Fanza97/DRAM-Tester/High Level Scheme.pdf

## SCRITTURA IN MEMORIA

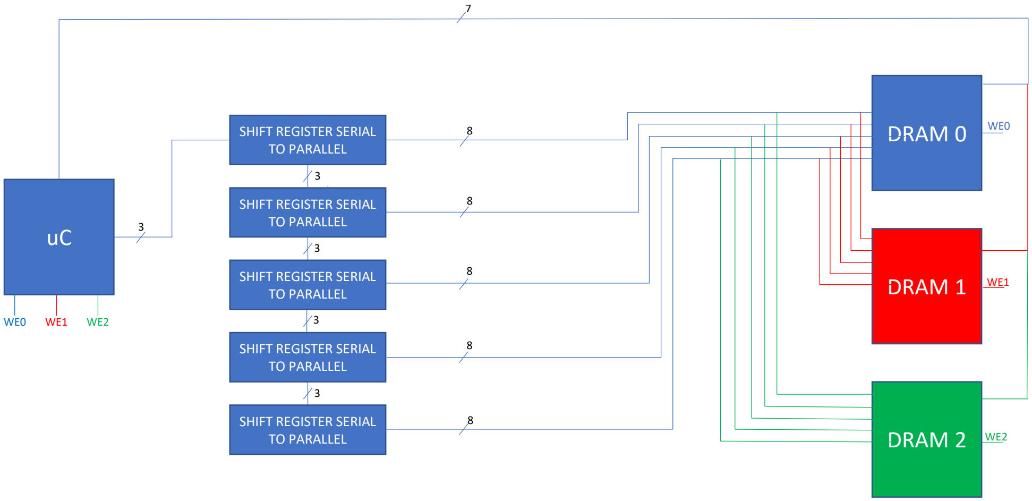
[picture p1: figure]
SHIFT REGISTER SERIAL TO PARALLEL; DRAM 0; DRAM 1; DRAM 2

## LETTURA DA MEMORIA

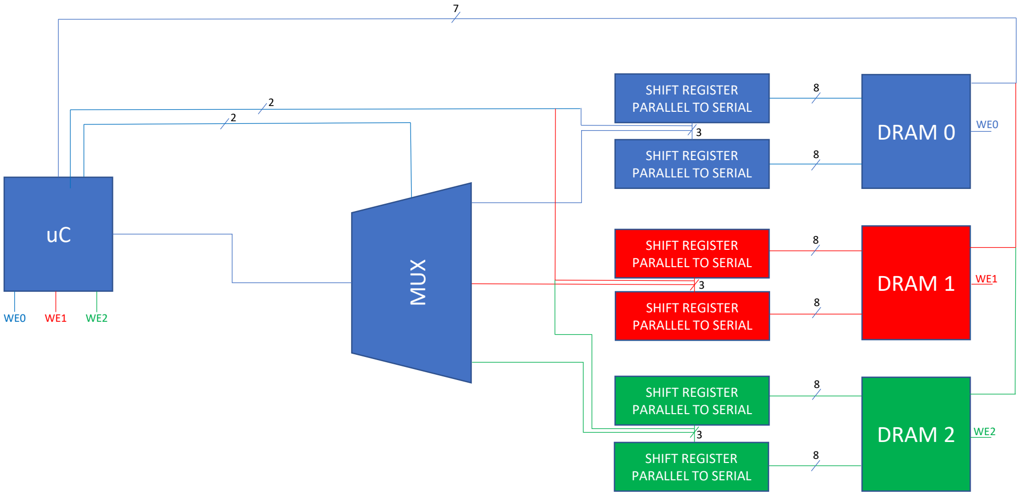
[picture p2: figure]
SHIFT REGISTER PARALLEL TO SERIAL; DRAM 0; DRAM 1; DRAM 2; MUX
