Fanza97/DRAM-Tester/Signals_Timing.pdf

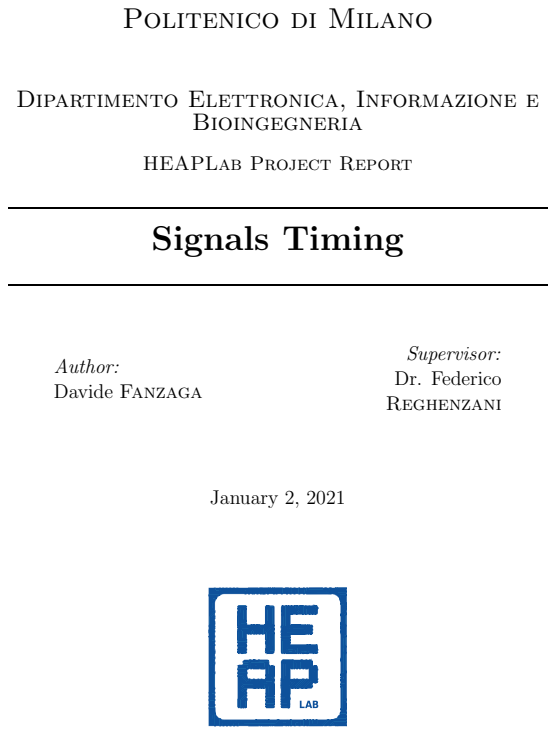
[picture p3: page 1]
Bioingegneria; Signals Timing; Author: Davide Fanzaga; Supervisor: Dr. Federico; Reghenzani; January 2, 2021

Politenico di Milano

Dipartimento Elettronica, Informazione e

HEAPLab Project Report

### 1 READ

### 1.1 DRAM

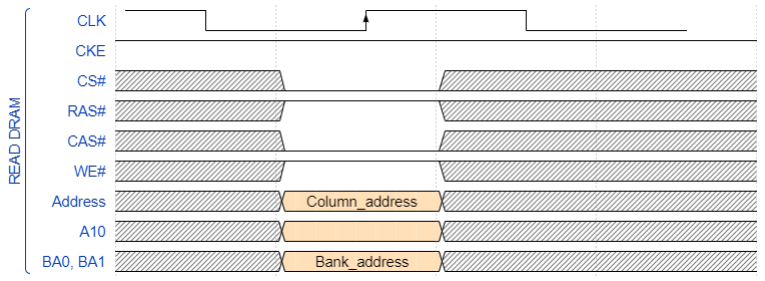
[picture p4: figure]

### 1.2 Shift Register Parallel to Serial

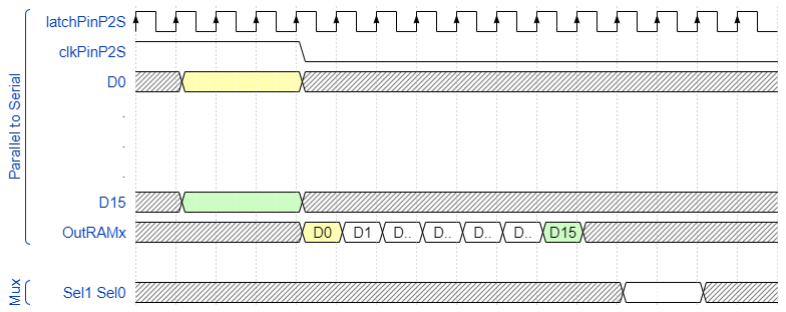
[picture p5: figure]

1

### 2 WRITE

### 2.1 DRAM

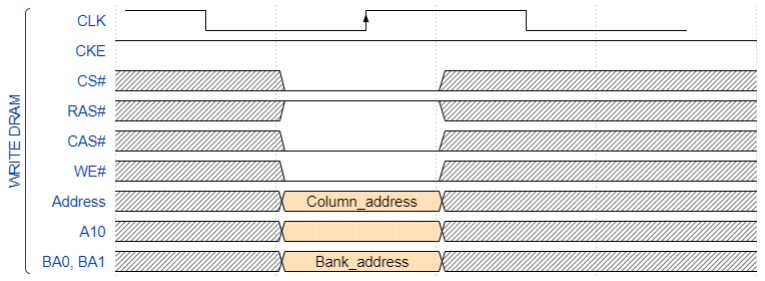
[picture p6: figure]

### 2.2 Shift RegisterSerial to Parallel

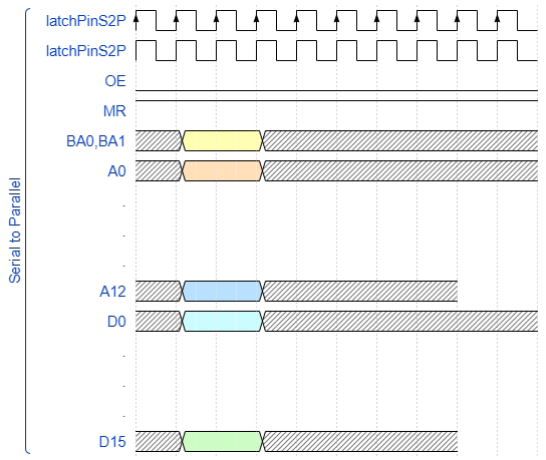
[picture p7: figure]

2
