Fanza97/DRAM-Tester/PCB_Design/PCB_Design.kicad_pcb

## KiCad design PCB_Design/PCB_Design.kicad_pcb (2021-08-06)

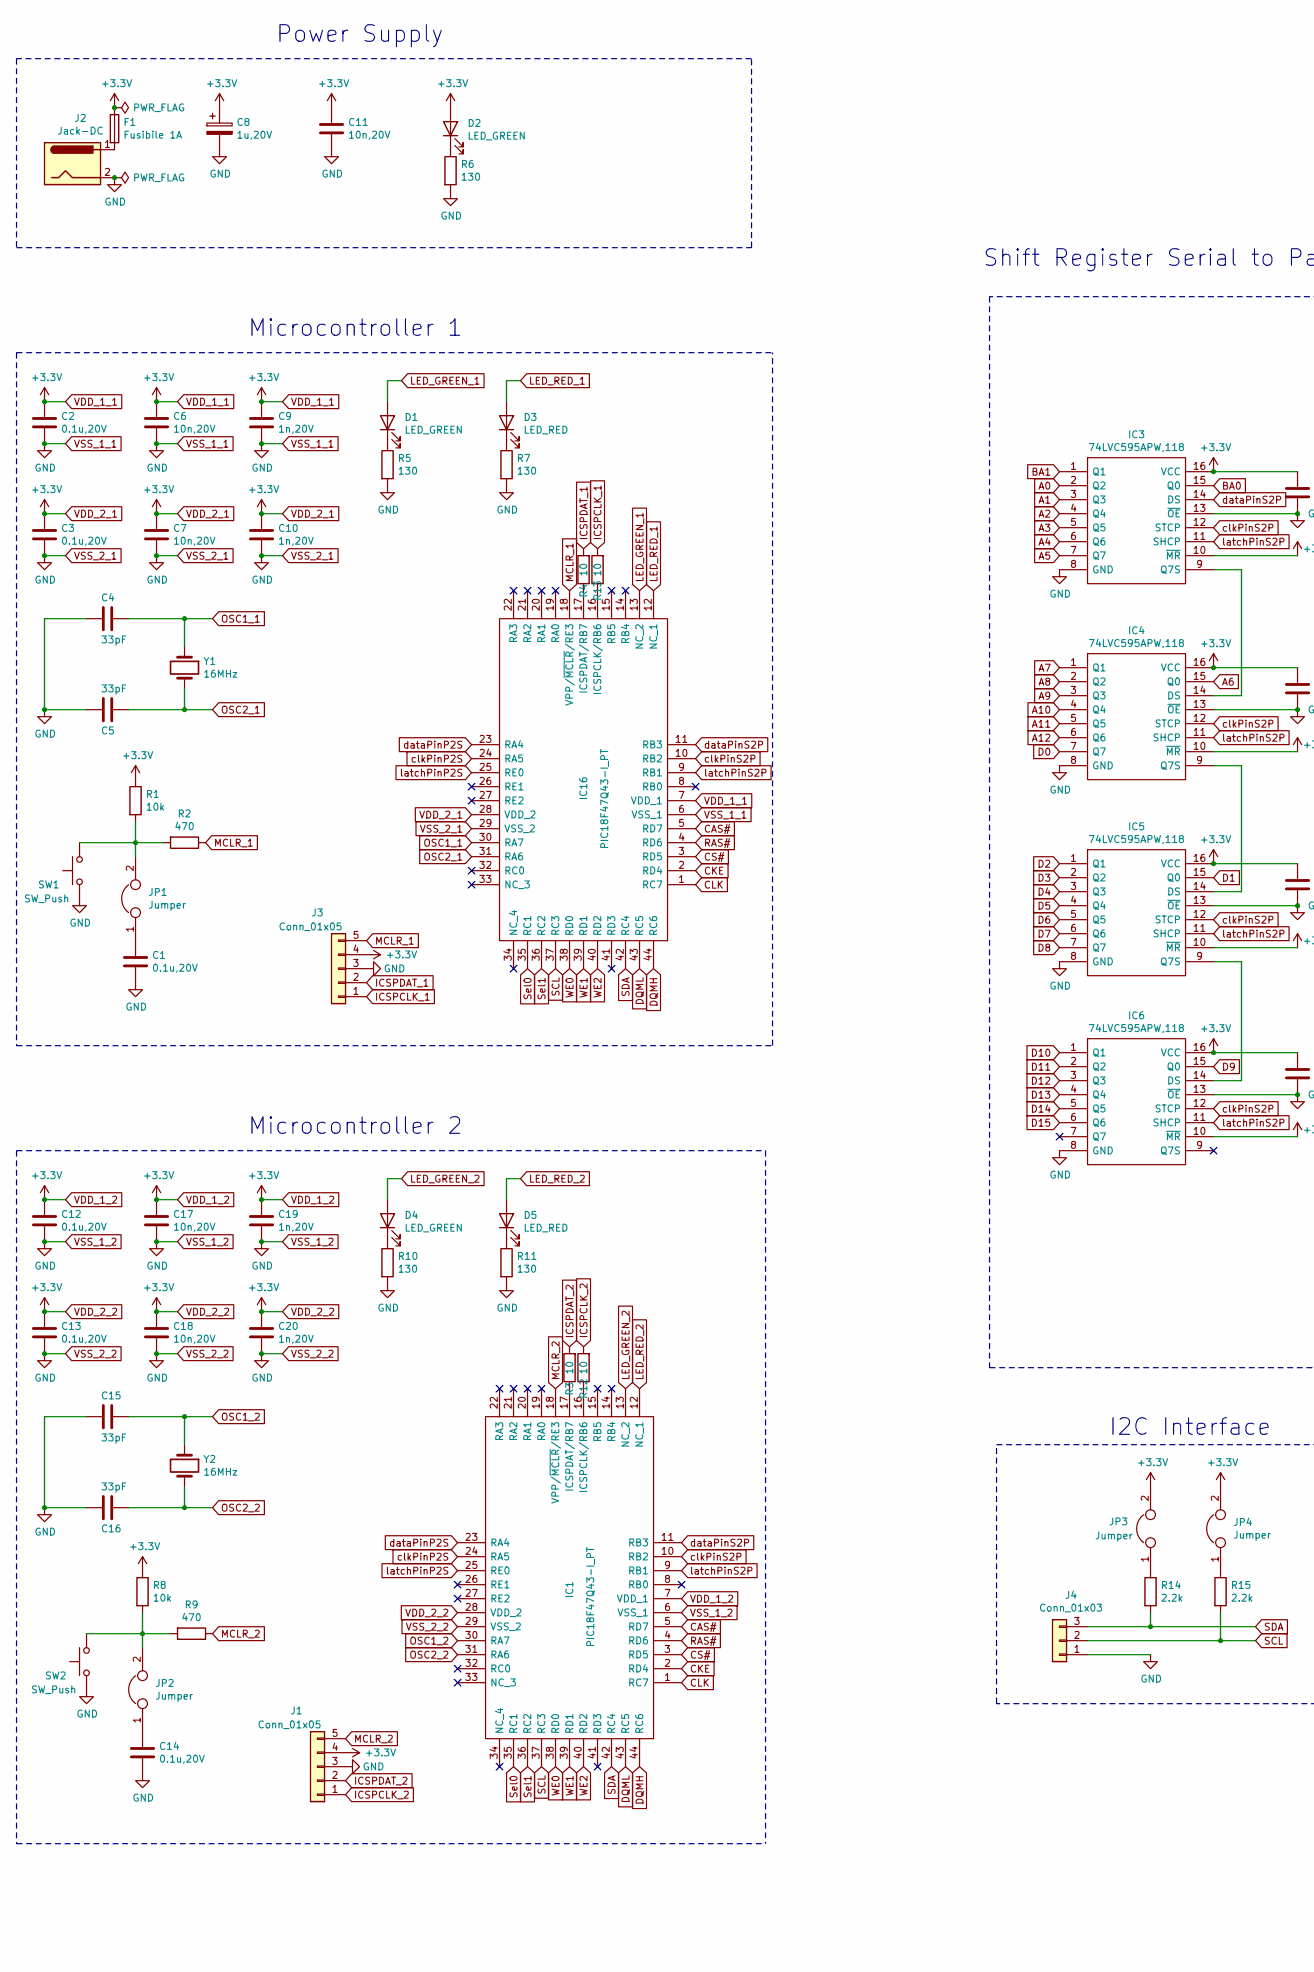
[picture p8: schematic PCB_Design.sch, part in row 1, column 1]

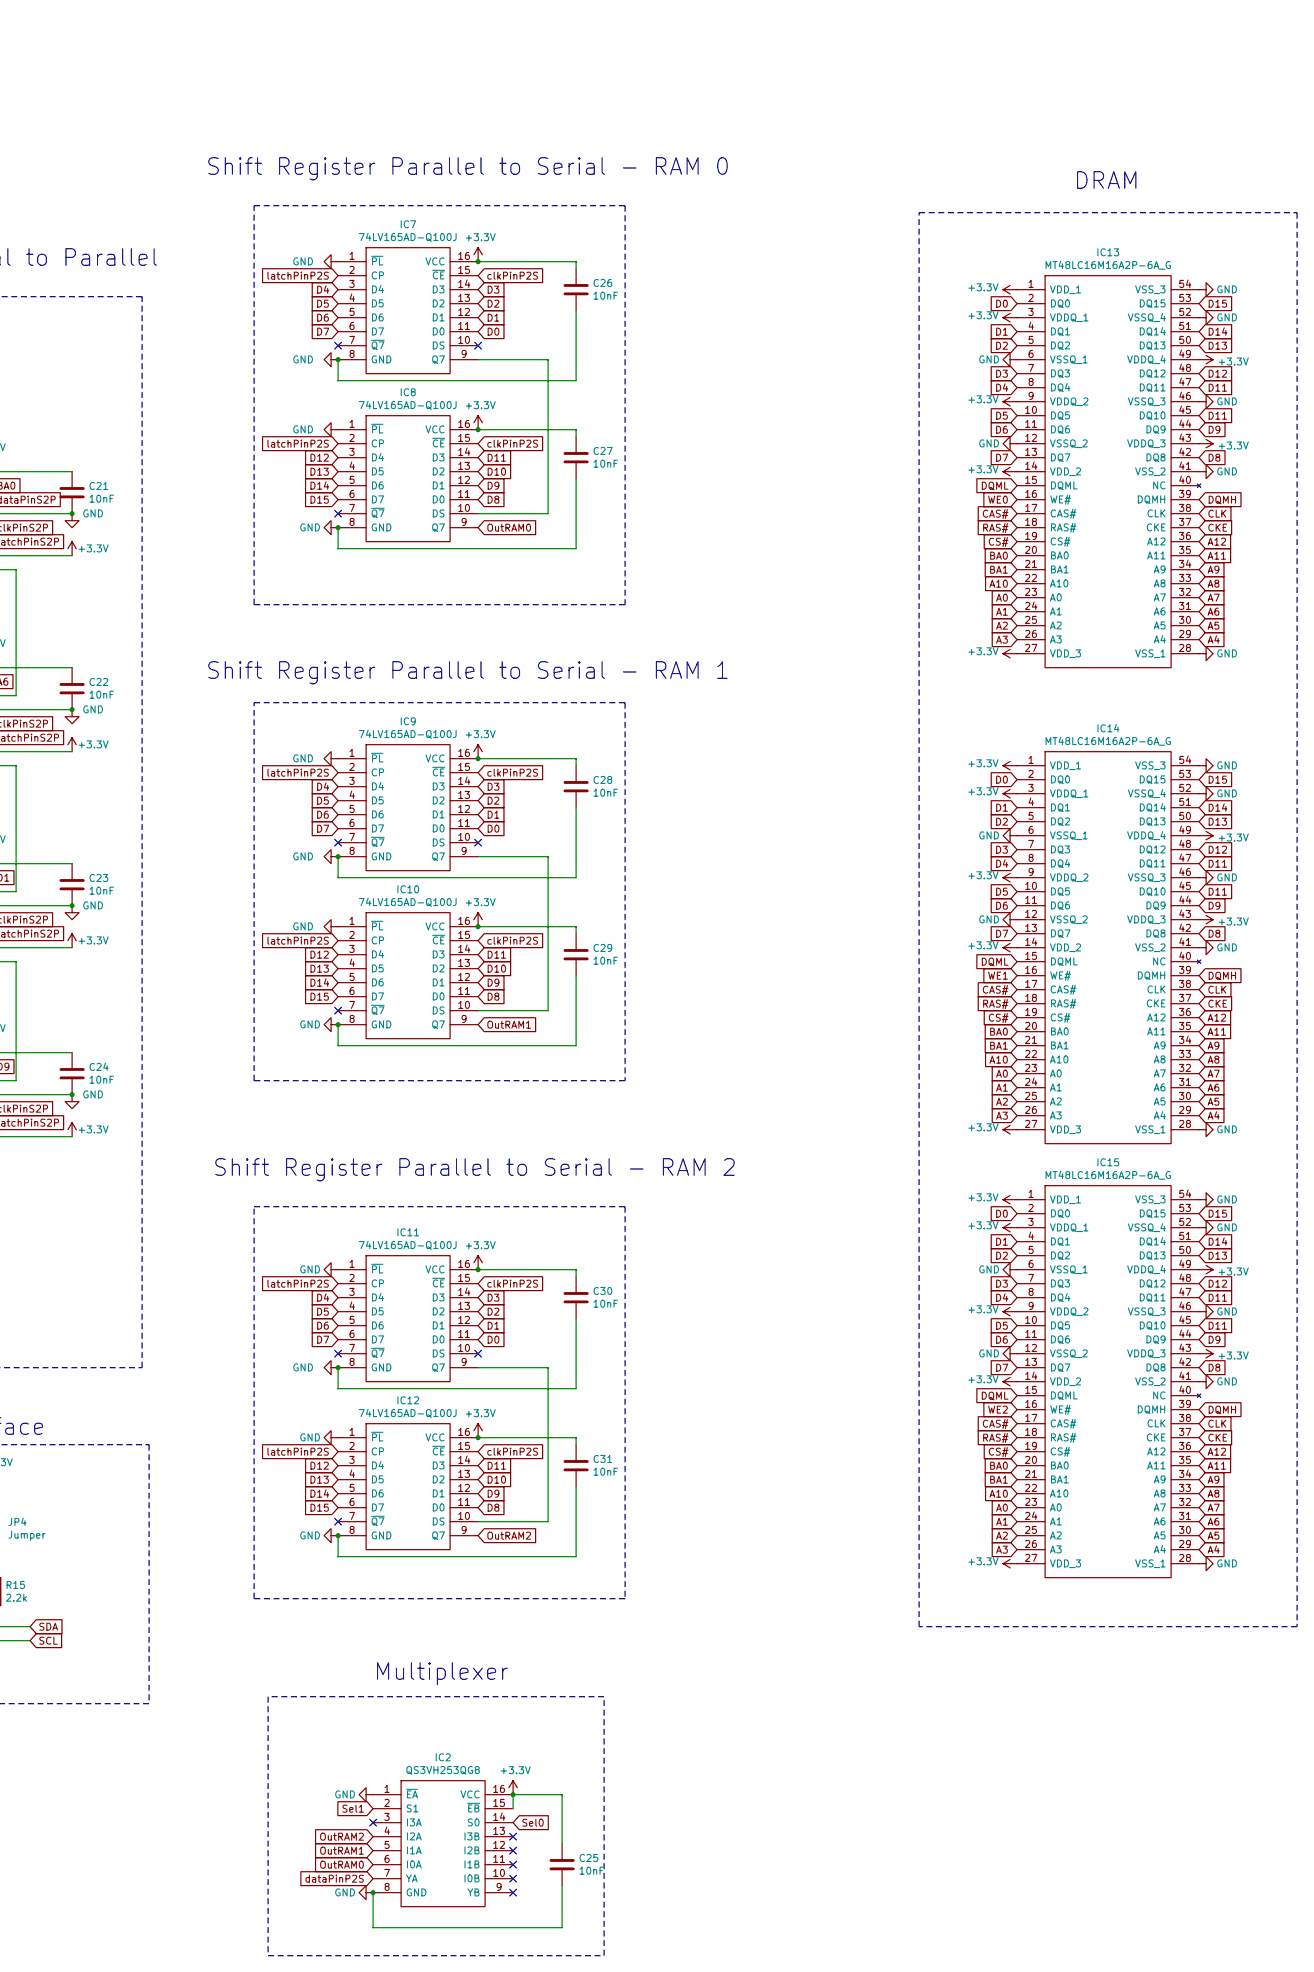
[picture p9: schematic PCB_Design.sch, part in row 1, column 2]

Parts:
C1, C2, C3, C12, C13, C14: 0.1u,20V; C_0805_2012Metric_Pad1.15x1.40mm_HandSolder
C4, C5, C15, C16: 33pF; C_0805_2012Metric_Pad1.15x1.40mm_HandSolder
C6, C7, C11, C17, C18: 10n,20V; C_0805_2012Metric_Pad1.15x1.40mm_HandSolder
C8: 1u,20V; CP_Elec_4x4.5
C9, C10, C19, C20: 1n,20V; C_0805_2012Metric_Pad1.15x1.40mm_HandSolder
C21, C22, C23, C24, C25, C26, C27, C28, C29, C30, C31: 10nF; C_0805_2012Metric_Pad1.15x1.40mm_HandSolder
D1, D2, D4: LED_GREEN; LED_0805_2012Metric_Pad1.15x1.40mm_HandSolder
D3, D5: LED_RED; LED_0805_2012Metric_Pad1.15x1.40mm_HandSolder
F1: Fusibile 1A; Fuseholder_Cylinder-5x20mm_Schurter_0031_8201_Horizontal_Op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
IC1, IC16: PIC18F47Q43-I_PT; QFP80P1200X1200X120-44N; Mouser Part Number 579-PIC18F47Q43-I/PT
IC2: QS3VH253QG8; SOP64P602X173-16N; Mouser Part Number 972-QS3VH253QG8
IC3, IC4, IC5, IC6: 74LVC595APW,118; SOP65P640X110-16N; Mouser Part Number 771-LVC595APW118
IC7, IC8, IC9, IC10, IC11, IC12: 74LV165AD-Q100J; SOIC127P600X175-16N; Mouser Part Number 771-74LV165ADQ100J
IC13, IC14, IC15: MT48LC16M16A2P-6A_G; SOP80P1176X120-54N; Mouser Part Number 340-128308-TRAY
J1, J3: Conn_01x05; PinHeader_1x05_P2.54mm_Vertical
J2: Jack-DC; BarrelJack_CUI_PJ-063AH_Horizontal
J4: Conn_01x03; PinHeader_1x03_P2.54mm_Vertical
JP1, JP2, JP3, JP4: Jumper; TestPoint_Bridge_Pitch2.54mm_Drill1.0mm
R1, R8: 10k; R_0805_2012Metric_Pad1.15x1.40mm_HandSolder
R2, R9: 470; R_0805_2012Metric_Pad1.15x1.40mm_HandSolder
R3, R4, R12, R13: 10; R_0805_2012Metric_Pad1.15x1.40mm_HandSolder
R5, R6, R7, R10, R11: 130; R_0805_2012Metric_Pad1.15x1.40mm_HandSolder
R14, R15: 2.2k; R_0805_2012Metric_Pad1.15x1.40mm_HandSolder
SW1, SW2: SW_Push; SW_PUSH_6mm_H5mm
Y1, Y2: 16MHz; Crystal_SMD_HC49-SD

Connections:
A0: IC3.2 (Q2), IC13.23 (A0), IC14.23 (A0), IC15.23 (A0)
A1: IC3.3 (Q3), IC13.24 (A1), IC14.24 (A1), IC15.24 (A1)
A2: IC3.4 (Q4), IC13.25 (A2), IC14.25 (A2), IC15.25 (A2)
A3: IC3.5 (Q5), IC13.26 (A3), IC14.26 (A3), IC15.26 (A3)
A4: IC3.6 (Q6), IC13.29 (A4), IC14.29 (A4), IC15.29 (A4)
A5: IC3.7 (Q7), IC13.30 (A5), IC14.30 (A5), IC15.30 (A5)
A6: IC4.15 (Q0), IC13.31 (A6), IC14.31 (A6), IC15.31 (A6)
A7: IC4.1 (Q1), IC13.32 (A7), IC14.32 (A7), IC15.32 (A7)
A8: IC4.2 (Q2), IC13.33 (A8), IC14.33 (A8), IC15.33 (A8)
A9: IC4.3 (Q3), IC13.34 (A9), IC14.34 (A9), IC15.34 (A9)
A10: IC4.4 (Q4), IC13.22 (A10), IC14.22 (A10), IC15.22 (A10)
A11: IC4.5 (Q5), IC13.35 (A11), IC14.35 (A11), IC15.35 (A11)
A12: IC4.6 (Q6), IC13.36 (A12), IC14.36 (A12), IC15.36 (A12)
BA0: IC3.15 (Q0), IC13.20 (BA0), IC14.20 (BA0), IC15.20 (BA0)
BA1: IC3.1 (Q1), IC13.21 (BA1), IC14.21 (BA1), IC15.21 (BA1)
CAS#: IC1.5 (RD7), IC13.17 (CAS#), IC14.17 (CAS#), IC15.17 (CAS#), IC16.5 (RD7)
CKE: IC1.2 (RD4), IC13.37 (CKE), IC14.37 (CKE), IC15.37 (CKE), IC16.2 (RD4)
CLK: IC1.1 (RC7), IC13.38 (CLK), IC14.38 (CLK), IC15.38 (CLK), IC16.1 (RC7)
CS#: IC1.3 (RD5), IC13.19 (CS#), IC14.19 (CS#), IC15.19 (CS#), IC16.3 (RD5)
D0: IC4.7 (Q7), IC7.11 (D0), IC9.11 (D0), IC11.11 (D0), IC13.2 (DQ0), IC14.2 (DQ0), IC15.2 (DQ0)
D1: IC5.15 (Q0), IC7.12 (D1), IC9.12 (D1), IC11.12 (D1), IC13.4 (DQ1), IC14.4 (DQ1), IC15.4 (DQ1)
D2: IC5.1 (Q1), IC7.13 (D2), IC9.13 (D2), IC11.13 (D2), IC13.5 (DQ2), IC14.5 (DQ2), IC15.5 (DQ2)
D3: IC5.2 (Q2), IC7.14 (D3), IC9.14 (D3), IC11.14 (D3), IC13.7 (DQ3), IC14.7 (DQ3), IC15.7 (DQ3)
D4: IC5.3 (Q3), IC7.3 (D4), IC9.3 (D4), IC11.3 (D4), IC13.8 (DQ4), IC14.8 (DQ4), IC15.8 (DQ4)
D5: IC5.4 (Q4), IC7.4 (D5), IC9.4 (D5), IC11.4 (D5), IC13.10 (DQ5), IC14.10 (DQ5), IC15.10 (DQ5)
D6: IC5.5 (Q5), IC7.5 (D6), IC9.5 (D6), IC11.5 (D6), IC13.11 (DQ6), IC14.11 (DQ6), IC15.11 (DQ6)
D7: IC5.6 (Q6), IC7.6 (D7), IC9.6 (D7), IC11.6 (D7), IC13.13 (DQ7), IC14.13 (DQ7), IC15.13 (DQ7)
D8: IC5.7 (Q7), IC8.11 (D0), IC10.11 (D0), IC12.11 (D0), IC13.42 (DQ8), IC14.42 (DQ8), IC15.42 (DQ8)
D9: IC6.15 (Q0), IC8.12 (D1), IC10.12 (D1), IC12.12 (D1), IC13.44 (DQ9), IC14.44 (DQ9), IC15.44 (DQ9)
D10: IC6.1 (Q1), IC8.13 (D2), IC10.13 (D2), IC12.13 (D2)
D11: IC6.2 (Q2), IC8.14 (D3), IC10.14 (D3), IC12.14 (D3), IC13.45 (DQ10), IC13.47 (DQ11), IC14.45 (DQ10), IC14.47 (DQ11), IC15.45 (DQ10), IC15.47 (DQ11)
D12: IC6.3 (Q3), IC8.3 (D4), IC10.3 (D4), IC12.3 (D4), IC13.48 (DQ12), IC14.48 (DQ12), IC15.48 (DQ12)
D13: IC6.4 (Q4), IC8.4 (D5), IC10.4 (D5), IC12.4 (D5), IC13.50 (DQ13), IC14.50 (DQ13), IC15.50 (DQ13)
D14: IC6.5 (Q5), IC8.5 (D6), IC10.5 (D6), IC12.5 (D6), IC13.51 (DQ14), IC14.51 (DQ14), IC15.51 (DQ14)
D15: IC6.6 (Q6), IC8.6 (D7), IC10.6 (D7), IC12.6 (D7), IC13.53 (DQ15), IC14.53 (DQ15), IC15.53 (DQ15)
DQMH: IC1.44 (RC6), IC13.39 (DQMH), IC14.39 (DQMH), IC15.39 (DQMH), IC16.44 (RC6)
DQML: IC1.43 (RC5), IC13.15 (DQML), IC14.15 (DQML), IC15.15 (DQML), IC16.43 (RC5)
ICSPCLK_1: J3.1, R13.2
ICSPCLK_2: J1.1, R12.2
ICSPDAT_1: J3.2, R4.2
ICSPDAT_2: J1.2, R3.2
LED_GREEN_1: D1.2 (A), IC16.13 (NC_2)
LED_GREEN_2: D4.2 (A), IC1.13 (NC_2)
LED_RED_1: D3.2 (A), IC16.12 (NC_1)
LED_RED_2: D5.2 (A), IC1.12 (NC_1)
MCLR_1: IC16.18 (VPP/~MCLR~/RE3), J3.5, R2.1
MCLR_2: IC1.18 (VPP/~MCLR~/RE3), J1.5, R9.1
unnamed: C1.2, JP1.1
unnamed: C14.2, JP2.1
unnamed: D1.1 (K), R5.1
unnamed: D2.1 (K), R6.1
unnamed: D3.1 (K), R7.1
unnamed: D4.1 (K), R10.1
unnamed: D5.1 (K), R11.1
unnamed: F1.2, J2.1
unnamed: IC1.16 (ICSPCLK/RB6), R12.1
unnamed: IC1.17 (ICSPDAT/RB7), R3.1
unnamed: IC3.9 (Q7S), IC4.14 (DS)
unnamed: IC4.9 (Q7S), IC5.14 (DS)
unnamed: IC5.9 (Q7S), IC6.14 (DS)
unnamed: IC7.9 (Q7), IC8.10 (DS)
unnamed: IC9.9 (Q7), IC10.10 (DS)
unnamed: IC11.9 (Q7), IC12.10 (DS)
unnamed: IC16.16 (ICSPCLK/RB6), R13.1
unnamed: IC16.17 (ICSPDAT/RB7), R4.1
unnamed: JP1.2, R1.2, R2.2, SW1.2
unnamed: JP2.2, R8.2, R9.2, SW2.2
unnamed: JP3.1, R14.1
unnamed: JP4.1, R15.1
OSC1_1: C4.2, IC16.30 (RA7), Y1.1
OSC1_2: C15.2, IC1.30 (RA7), Y2.1
OSC2_1: C5.2, IC16.31 (RA6), Y1.2
OSC2_2: C16.2, IC1.31 (RA6), Y2.2
OutRAM0: IC2.6 (I0A), IC8.9 (Q7)
OutRAM1: IC2.5 (I1A), IC10.9 (Q7)
OutRAM2: IC2.4 (I2A), IC12.9 (Q7)
RAS#: IC1.4 (RD6), IC13.18 (RAS#), IC14.18 (RAS#), IC15.18 (RAS#), IC16.4 (RD6)
SCL: IC1.37 (RC3), IC16.37 (RC3), J4.2, R15.2
SDA: IC1.42 (RC4), IC16.42 (RC4), J4.3, R14.2
Sel0: IC1.35 (RC1), IC2.14 (S0), IC16.35 (RC1)
Sel1: IC1.36 (RC2), IC2.2 (S1), IC16.36 (RC2)
VDD_1_1: C2.2, C3.2, C6.2, C7.2, C8.1, C9.2, C10.2, C11.2, C12.2, C13.2, C17.2, C18.2, C19.2, C20.2, C21.1, C22.1, C23.1, C24.1, C25.1, C26.1, C27.1, C28.1, C29.1, C30.1, C31.1, D2.2 (A), F1.1, IC1.7 (VDD_1), IC1.28 (VDD_2), IC2.15 (~EB), IC2.16 (VCC), IC3.10 (~MR), IC3.16 (VCC), IC4.10 (~MR), IC4.16 (VCC), IC5.10 (~MR), IC5.16 (VCC), IC6.10 (~MR), IC6.16 (VCC), IC7.16 (VCC), IC8.16 (VCC), IC9.16 (VCC), IC10.16 (VCC), IC11.16 (VCC), IC12.16 (VCC), IC13.1 (VDD_1), IC13.3 (VDDQ_1), IC13.9 (VDDQ_2), IC13.14 (VDD_2), IC13.27 (VDD_3), IC13.43 (VDDQ_3), IC13.49 (VDDQ_4), IC14.1 (VDD_1), IC14.3 (VDDQ_1), IC14.9 (VDDQ_2), IC14.14 (VDD_2), IC14.27 (VDD_3), IC14.43 (VDDQ_3), IC14.49 (VDDQ_4), IC15.1 (VDD_1), IC15.3 (VDDQ_1), IC15.9 (VDDQ_2), IC15.14 (VDD_2), IC15.27 (VDD_3), IC15.43 (VDDQ_3), IC15.49 (VDDQ_4), IC16.7 (VDD_1), IC16.28 (VDD_2), J1.4, J3.4, JP3.2, JP4.2, R1.1, R8.1
VSS_1_1: C1.1, C2.1, C3.1, C4.1, C5.1, C6.1, C7.1, C8.2, C9.1, C10.1, C11.1, C12.1, C13.1, C14.1, C15.1, C16.1, C17.1, C18.1, C19.1, C20.1, C21.2, C22.2, C23.2, C24.2, C25.2, C26.2, C27.2, C28.2, C29.2, C30.2, C31.2, IC1.6 (VSS_1), IC1.29 (VSS_2), IC2.1 (~EA), IC2.8 (GND), IC3.8 (GND), IC3.13 (~OE), IC4.8 (GND), IC4.13 (~OE), IC5.8 (GND), IC5.13 (~OE), IC6.8 (GND), IC6.13 (~OE), IC7.1 (~PL), IC7.8 (GND), IC8.1 (~PL), IC8.8 (GND), IC9.1 (~PL), IC9.8 (GND), IC10.1 (~PL), IC10.8 (GND), IC11.1 (~PL), IC11.8 (GND), IC12.1 (~PL), IC12.8 (GND), IC13.6 (VSSQ_1), IC13.12 (VSSQ_2), IC13.28 (VSS_1), IC13.41 (VSS_2), IC13.46 (VSSQ_3), IC13.52 (VSSQ_4), IC13.54 (VSS_3), IC14.6 (VSSQ_1), IC14.12 (VSSQ_2), IC14.28 (VSS_1), IC14.41 (VSS_2), IC14.46 (VSSQ_3), IC14.52 (VSSQ_4), IC14.54 (VSS_3), IC15.6 (VSSQ_1), IC15.12 (VSSQ_2), IC15.28 (VSS_1), IC15.41 (VSS_2), IC15.46 (VSSQ_3), IC15.52 (VSSQ_4), IC15.54 (VSS_3), IC16.6 (VSS_1), IC16.29 (VSS_2), J1.3, J2.2, J3.3, J4.1, R5.2, R6.2, R7.2, R10.2, R11.2, SW1.1, SW2.1
WE0: IC1.38 (RD0), IC13.16 (WE#), IC16.38 (RD0)
WE1: IC1.39 (RD1), IC14.16 (WE#), IC16.39 (RD1)
WE2: IC1.40 (RD2), IC15.16 (WE#), IC16.40 (RD2)
clkPinP2S: IC1.24 (RA5), IC7.15 (~CE), IC8.15 (~CE), IC9.15 (~CE), IC10.15 (~CE), IC11.15 (~CE), IC12.15 (~CE), IC16.24 (RA5)
clkPinS2P: IC1.10 (RB2), IC3.12 (STCP), IC4.12 (STCP), IC5.12 (STCP), IC6.12 (STCP), IC16.10 (RB2)
dataPinP2S: IC1.23 (RA4), IC2.7 (YA), IC16.23 (RA4)
dataPinS2P: IC1.11 (RB3), IC3.14 (DS), IC16.11 (RB3)
latchPinP2S: IC1.25 (RE0), IC7.2 (CP), IC8.2 (CP), IC9.2 (CP), IC10.2 (CP), IC11.2 (CP), IC12.2 (CP), IC16.25 (RE0)
latchPinS2P: IC1.9 (RB1), IC3.11 (SHCP), IC4.11 (SHCP), IC5.11 (SHCP), IC6.11 (SHCP), IC16.9 (RB1)

Notes on the sheet:
Shift Register Serial to Parallel
Shift Register Parallel to Serial - RAM 0
Shift Register Parallel to Serial - RAM 1
Shift Register Parallel to Serial - RAM 2
DRAM
Multiplexer
Microcontroller 1
Power Supply
Microcontroller 2
I2C Interface

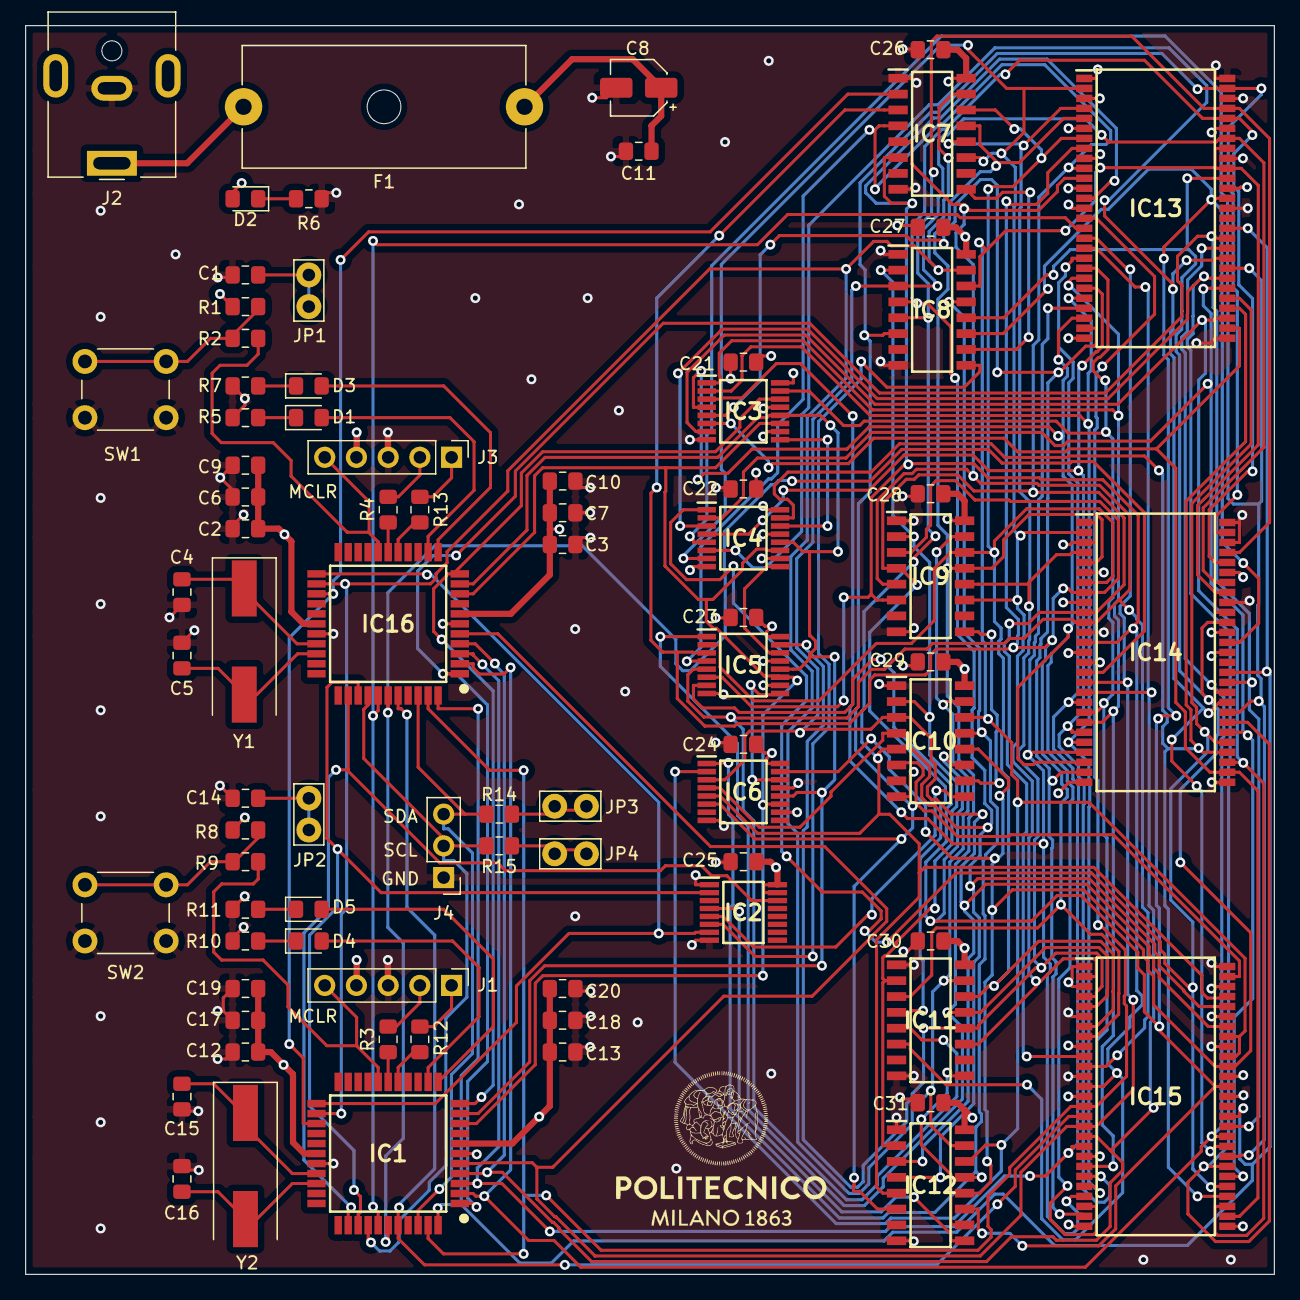
[picture p10: board PCB_Design.kicad_pcb from above]

Board: 4 copper layers, 100.0 x 100.0 mm, 80 parts (0 on the bottom side), 92 nets.
